SahejAgarwal05/The-Amazing-Robot/README.md

# The Amazing Robot

Read FinalReport.pdf
